adafruit/Adafruit-Metro-M7-with-microSD-PCB/Adafruit Metro M7 microSD Pinout.pdf

# Adafruit Metro M7 microSD

# https://www.adafruit.com/product/5600

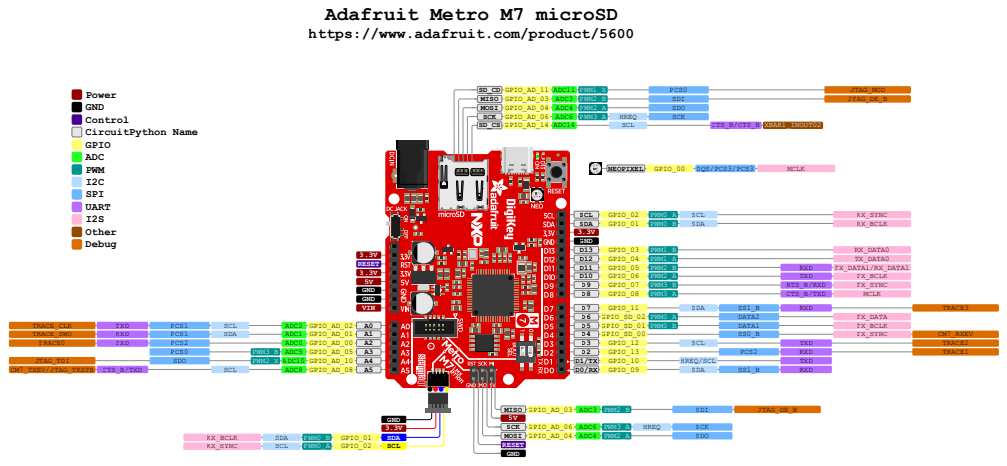
[picture p2: page 1]
